Muondetectorau/Muondetectorproject/models/README.md

# Космические мюоны: Монте-Карло симуляция 

Интерактивная физическая симуляция прохождения космических мюонов через вещество и калибровка сцинтилляционного детектора.



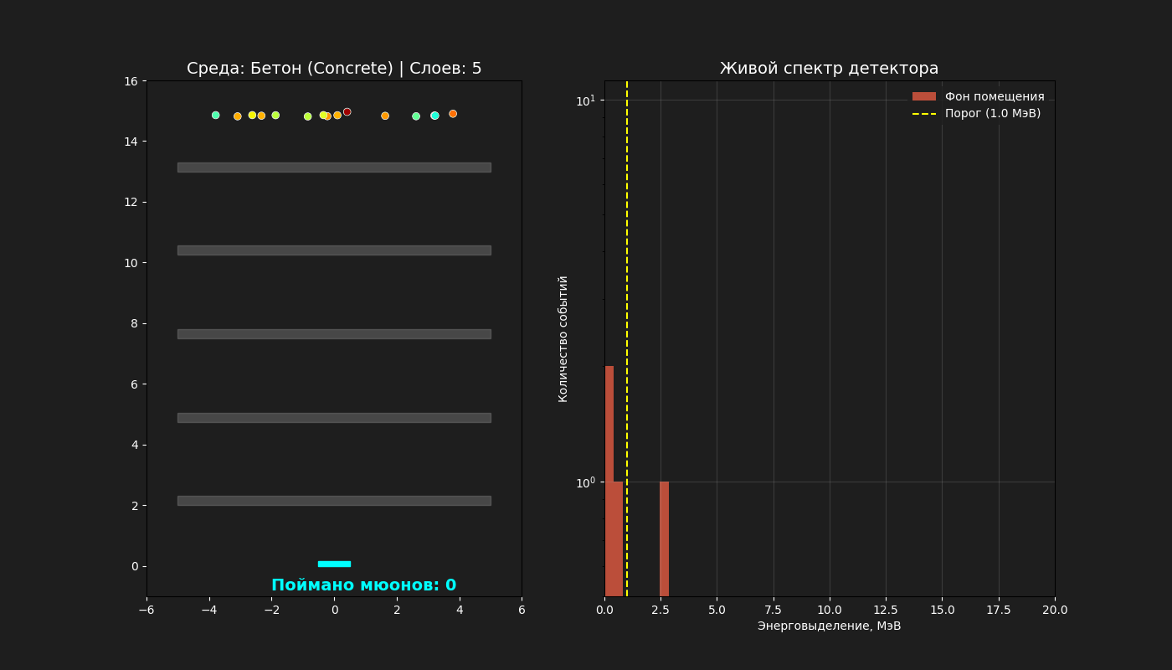
[picture p3: models/muon_simulation_live.gif]
Скриншот приложения
 

## Что внутри:
-  Честный Монте-Карло движок (Ray-marching) потерь энергии по формуле Бете-Блоха.
-  Моделирование спектра Ландау в тонких пластиковых сцинтилляторах.
-  Оптимизация соотношения Сигнал/Шум при наличии радиационного фона.
-  Анализ статистики Пуассона и барометрического эффекта.

## Как запустить:
1. Установите зависимости: `pip install -r requirements.txt`
2. Запустите веб-интерфейс: `streamlit run web_app.py`
