Muondetectorau/Muondetectorproject/docs/README.md

<div align="center">

**Высокоскоростная регистрация слабого света на базе кремниевых фотоэлектронных умножителей (SiPM) C-Series от onsemi**






Project Banner

*Проект использует  твердотельный сенсор MicroFc-60035 (SiPM) для детектирования одиночных фотонов от УФ до видимого спектра с пиковой чувствительностью в синей области.*

</div>

---

##  О проекте

Данный проект , использует низкошумящие кремниевые фотоэлектронные умножители (SiPM) **C-Series** производства **onsemi**. 

Сенсоры обладают характеристиками, аналогичными традиционным фотоэлектронным умножителям (ФЭУ - PMT), но предлагают все практические преимущества твердотельной технологии: низкое рабочее напряжение, превосходную температурную стабильность, компактность и низкую стоимость.

##  Ключевые особенности (Hardware)

-  **Чувствительность:** Оптимизированы для синего спектра (пик на 420 нм). Широкий диапазон 300–950 нм.
-  **Низкий уровень шума:** Индустриальный стандарт низкого уровня темнового счета (Dark Count Rate) в сочетании с высокой эффективностью детектирования фотонов (PDE).
-  **Удобный форм-фактор:** SMT корпуса (1 мм, 3 мм, 6 мм) совместимые со стандартной пайкой оплавлением (Lead-free).

---

## Технические характеристики сенсоров

| Параметр | Значение (Тип.) | Ед. изм. | Примечание |
| :--- | :---: | :---: | :--- |
| **Спектральный диапазон** | 300 – 950 | нм | УФ и видимый свет |
| **Пиковая длина волны ($\lambda_p$)** | 420 | нм | |
| **Напряжение пробоя (Vbr)** | 24.2 – 24.7 | В | При 21°C |
| **Рекомендуемое перенапряжение** | 1.0 – 5.0 | В | Выше значения Vbr |
| **Коэффициент усиления (Gain)** | $2 \times 10^5$ – $6 \times 10^6$| - | В зависимости от размера микроячейки |
| **Время нарастания (Fast Output)** | 0.3 – 1.0 | нс | От 10% до 90% амплитуды |

<details>
<summary><b> Развернуть подробности о конфигурации выводов</b></summary>

Сенсор представляет собой массив микроячеек, суммированных вместе, и работает как единый фотодиод с 3 выводами:
1. **Anode** (Анод) — Стандартный выход
2. **Cathode** (Катод) — Подача смещения (Vbias)
3. **Fast Output** — Быстрый выход для прецизионного тайминга
