Muondetectorau/Muondetectorproject/(commit log)

2026-05-12 Большая часть проекта
2026-05-14 Добавлен хостинг для симуляции
2026-05-15 Добавлен код для распределения Ландау и барометрического эффекта
